joepisconte/Monitoreo-de-Temperatura-de-Pulpa-de-Uva/Fotos de la Calibración de Sensores/3.jpg

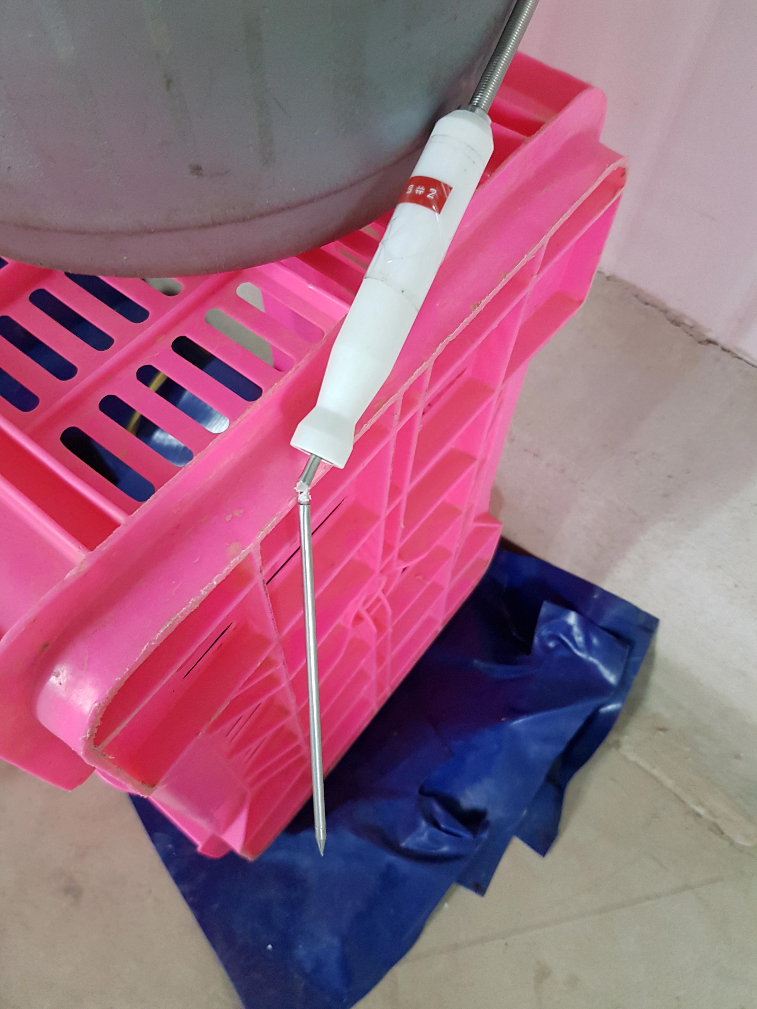
Fotos de la Calibración de Sensores/3.jpg
