joepisconte/Monitoreo-de-Temperatura-de-Pulpa-de-Uva/Librerías para Arduino/PlayingWithFusion_MAX31865/readme.txt

For information on installing libraries, see: http://arduino.cc/en/Guide/Libraries
visit www.playingwithfusion.com for more details, application notes and more!
