joepisconte/Monitoreo-de-Temperatura-de-Pulpa-de-Uva/Programa para Android/Nota.txt

Programa para Android que permite calibrar los tableros de túneles y cámaras.
El PIN de emparejamiento de los módulos Bluetooth es: 2427
