joepisconte/Monitoreo-de-Temperatura-de-Pulpa-de-Uva/Diagramas de Tableros/Tablero de Cámaras.jpg

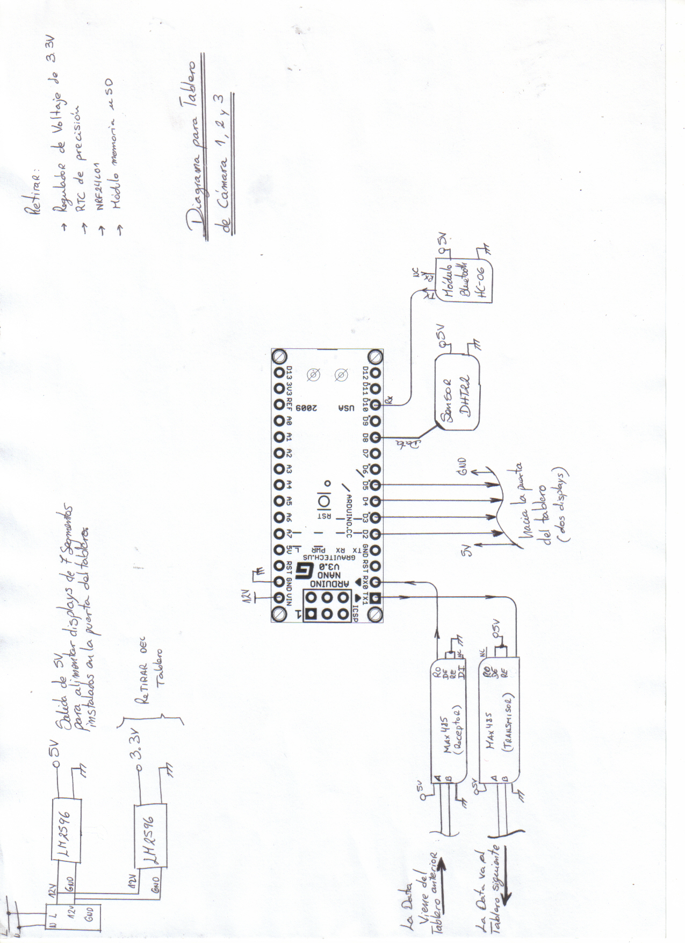
Diagramas de Tableros/Tablero de Cámaras.jpg
