joepisconte/Monitoreo-de-Temperatura-de-Pulpa-de-Uva/Diagramas de Tableros/Tablero de Tuneles.jpg

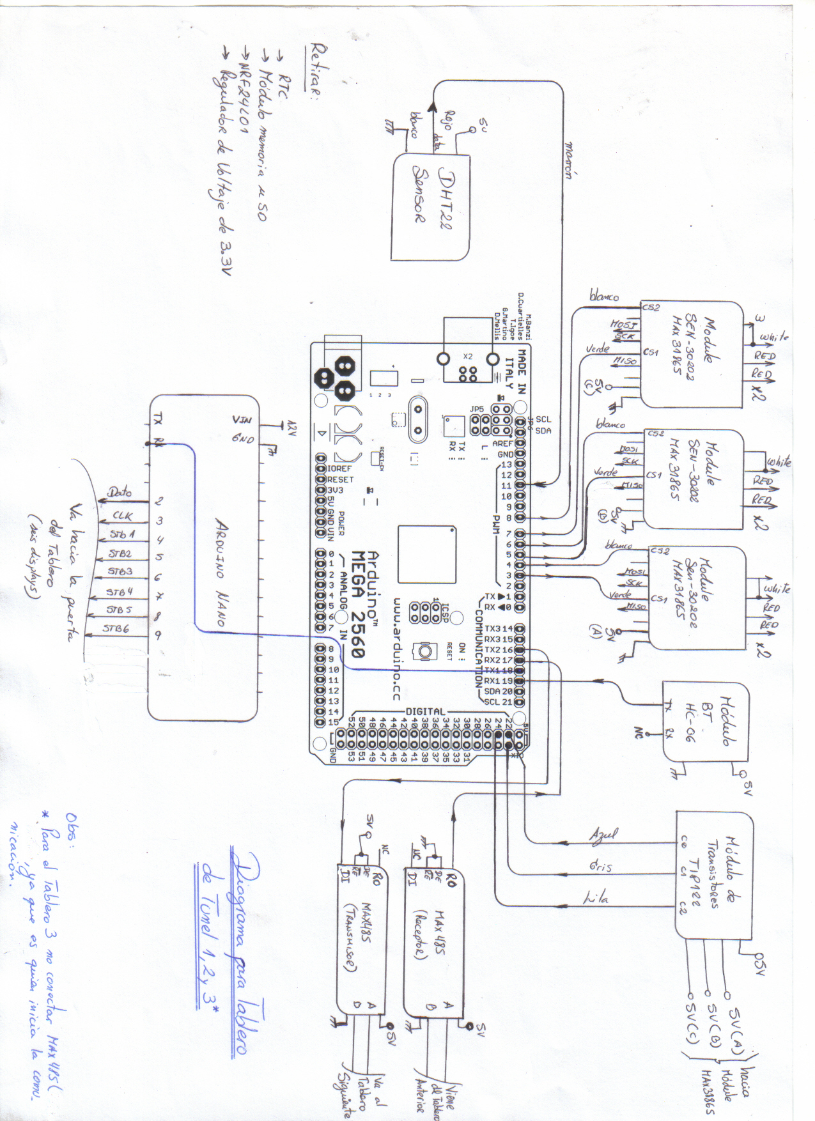
Diagramas de Tableros/Tablero de Tuneles.jpg
