joepisconte/Monitoreo-de-Temperatura-de-Pulpa-de-Uva/Diagramas de Tableros/Tablero Master.jpg

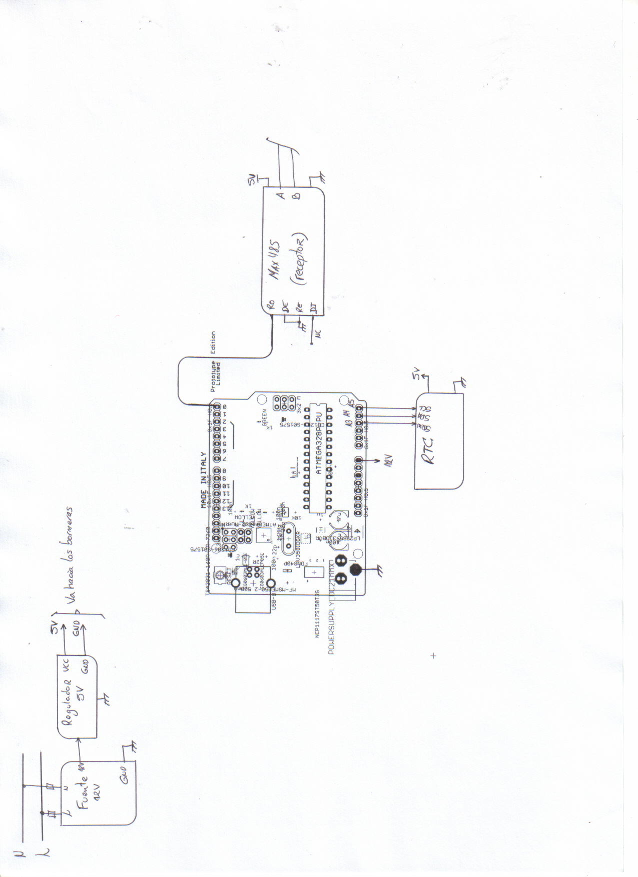
Diagramas de Tableros/Tablero Master.jpg
