joepisconte/Monitoreo-de-Temperatura-de-Pulpa-de-Uva/Fotos de la Calibración de Sensores/Nota.txt

Estas fotos corresponden a la calibración realizada el 21 de Octubre del 2016 en las intalaciones de la empresa Fresch Fruits SRL ubicada en CETICOS PAITA - PIURA - PERÚ.
