joepisconte/Monitoreo-de-Temperatura-de-Pulpa-de-Uva/Fotos de la Calibración de Sensores/1.jpg

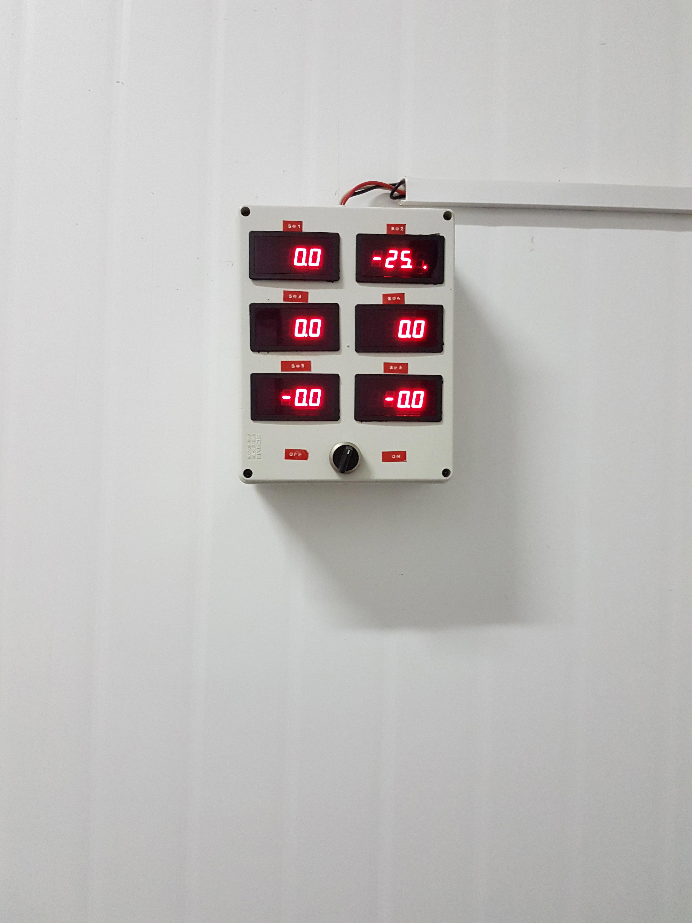
Fotos de la Calibración de Sensores/1.jpg
