joepisconte/Monitoreo-de-Temperatura-de-Pulpa-de-Uva/Fotos de la Calibración de Sensores/7.jpg

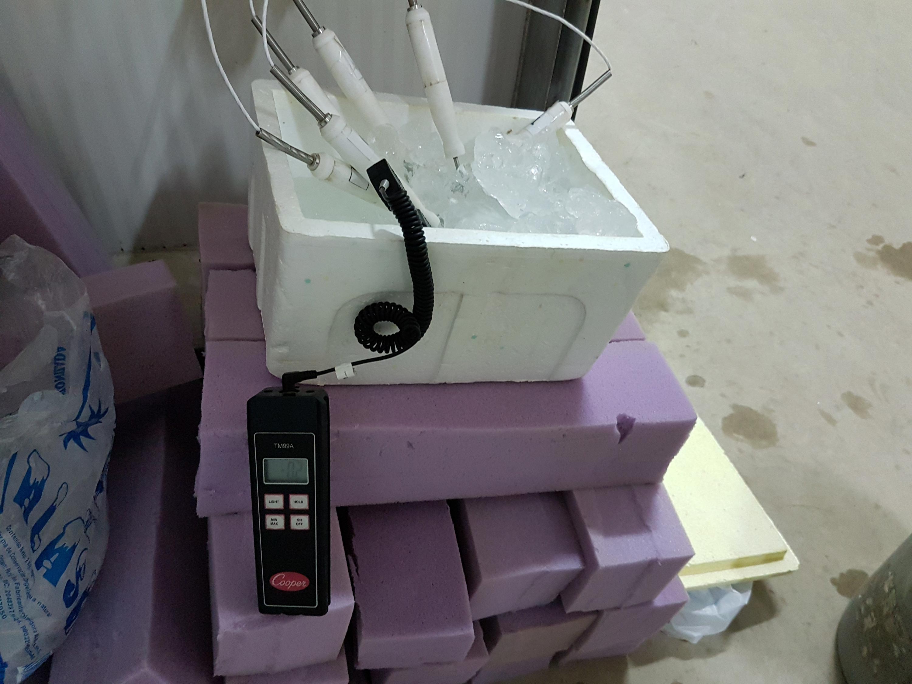
Fotos de la Calibración de Sensores/7.jpg
