joepisconte/Monitoreo-de-Temperatura-de-Pulpa-de-Uva/Librerías para Arduino/PlayingWithFusion_MAX31865/examples/max31865_2ch_spi_example/max31865_2ch_spi_example.ino

/***************************************************************************
* File Name: serial_MAX31865.h
* Processor/Platform: Arduino Uno R3 (tested)
* Development Environment: Arduino 1.0.5
*
* Designed for use with with Playing With Fusion MAX31865 Resistance
* Temperature Device (RTD) breakout board: SEN-30202 (PT100 or PT1000)
*   ---> http://playingwithfusion.com/productview.php?pdid=25
*   ---> http://playingwithfusion.com/productview.php?pdid=26
*
* Copyright © 2014 Playing With Fusion, Inc.
* SOFTWARE LICENSE AGREEMENT: This code is released under the MIT License. 
* 
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
* Playing With Fusion, Inc. invests time and resources developing open-source
* code. Please support Playing With Fusion and continued open-source 
* development by buying products from Playing With Fusion!
*
* **************************************************************************
* ADDITIONAL NOTES:
* This file configures then runs a program on an Arduino Uno to read a 2-ch
* MAX31865 RTD-to-digital converter breakout board and print results to
* a serial port. Communication is via SPI built-in library.
*    - Configure Arduino Uno
*    - Configure and read resistances and statuses from MAX31865 IC 
*      - Write config registers (MAX31865 starts up in a low-power state)
*      - RTD resistance register
*      - High and low status thresholds 
*      - Fault statuses
*    - Write formatted information to serial port
*  Circuit:
*    Arduino Uno   Arduino Mega  -->  SEN-30201
*    CS0: pin  9   CS0: pin  9   -->  CS, CH0
*    CS1: pin 10   CS1: pin 10   -->  CS, CH1
*    MOSI: pin 11  MOSI: pin 51  -->  SDI (must not be changed for hardware SPI)
*    MISO: pin 12  MISO: pin 50  -->  SDO (must not be changed for hardware SPI)
*    SCK:  pin 13  SCK:  pin 52  -->  SCLK (must not be changed for hardware SPI)
*    GND           GND           -->  GND
*    5V            5V            -->  Vin (supply with same voltage as Arduino I/O, 5V)
***************************************************************************/

// the sensor communicates using SPI, so include the hardware SPI library:
#include <SPI.h>
// include Playing With Fusion MAX31865 libraries
#include <PlayingWithFusion_MAX31865.h>              // core library
#include <PlayingWithFusion_MAX31865_STRUCT.h>       // struct library

// CS pin used for the connection with the sensor
// other connections are controlled by the SPI library)
const int CS0_PIN = 9;
const int CS1_PIN = 10;

PWFusion_MAX31865_RTD rtd_ch0(CS0_PIN);
PWFusion_MAX31865_RTD rtd_ch1(CS1_PIN);

void setup() {
  Serial.begin(115200);

  // setup for the the SPI library:
  SPI.begin();                            // begin SPI
  SPI.setClockDivider(SPI_CLOCK_DIV16);   // SPI speed to SPI_CLOCK_DIV16 (1MHz)
  SPI.setDataMode(SPI_MODE3);             // MAX31865 works in MODE1 or MODE3
  
  // initalize the chip select pin
  pinMode(CS0_PIN, OUTPUT);
  pinMode(CS1_PIN, OUTPUT);
  rtd_ch0.MAX31865_config();
  rtd_ch1.MAX31865_config();
  
  // give the sensor time to set up
  delay(100);
}


void loop() 
{
  delay(1500);                                   // 1500ms delay... can be much faster
  

  static struct var_max31865 RTD_CH0;
  static struct var_max31865 RTD_CH1;
  double tmp;
  
  RTD_CH0.RTD_type = 1;                         // un-comment for PT100 RTD
  // RTD_CH0.RTD_type = 2;                        // un-comment for PT1000 RTD
  RTD_CH1.RTD_type = 1;                         // un-comment for PT100 RTD
  // RTD_CH0.RTD_type = 2;                        // un-comment for PT1000 RTD
  
  struct var_max31865 *rtd_ptr;
  rtd_ptr = &RTD_CH0;
  rtd_ch0.MAX31865_full_read(rtd_ptr);          // Update MAX31855 readings 
  
  rtd_ptr = &RTD_CH1;
  rtd_ch1.MAX31865_full_read(rtd_ptr);          // Update MAX31855 readings 
  
  // ******************** Print RTD 0 Information ********************
  Serial.println("RTD Sensor 0:");              // Print RTD0 header
  
  if(0 == RTD_CH0.status)                       // no fault, print info to serial port
  {
    if(1 == RTD_CH0.RTD_type)                   // handle values for PT100
    {
      // calculate RTD resistance
      tmp = (double)RTD_CH0.rtd_res_raw * 400 / 32768;
      Serial.print("Rrtd = ");                  // print RTD resistance heading
      Serial.print(tmp);                        // print RTD resistance
    }
    else if(2 == RTD_CH0.RTD_type)              // handle values for PT1000
    {
      // calculate RTD resistance
      tmp = (double)RTD_CH0.rtd_res_raw * 4000 / 32768;
      Serial.print("Rrtd = ");                  // print RTD resistance heading
      Serial.print(tmp);                        // print RTD resistance
    }
    Serial.println(" ohm");
    // calculate RTD temperature (simple calc, +/- 2 deg C from -100C to 100C)
    // more accurate curve can be used outside that range
    tmp = ((double)RTD_CH0.rtd_res_raw / 32) - 256;
    Serial.print("Trtd = ");                    // print RTD temperature heading
    Serial.print(tmp);                          // print RTD resistance
    Serial.println(" deg C");                   // print RTD temperature heading
  }  // end of no-fault handling
  else 
  {
    Serial.print("RTD Fault, register: ");
    Serial.print(RTD_CH0.status);
    if(0x80 & RTD_CH0.status)
    {
      Serial.println("RTD High Threshold Met");  // RTD high threshold fault
    }
    else if(0x40 & RTD_CH0.status)
    {
      Serial.println("RTD Low Threshold Met");   // RTD low threshold fault
    }
    else if(0x20 & RTD_CH0.status)
    {
      Serial.println("REFin- > 0.85 x Vbias");   // REFin- > 0.85 x Vbias
    }
    else if(0x10 & RTD_CH0.status)
    {
      Serial.println("FORCE- open");             // REFin- < 0.85 x Vbias, FORCE- open
    }
    else if(0x08 & RTD_CH0.status)
    {
      Serial.println("FORCE- open");             // RTDin- < 0.85 x Vbias, FORCE- open
    }
    else if(0x04 & RTD_CH0.status)
    {
      Serial.println("Over/Under voltage fault");  // overvoltage/undervoltage fault
    }
    else
    {
      Serial.println("Unknown fault, check connection"); // print RTD temperature heading
    }
  }  // end of fault handling
  
  
  // ******************** Print RTD 1 Information ********************
  Serial.println("RTD Sensor 1:");              // Print RTD0 header
  
  if(0 == RTD_CH1.status)                       // no fault, print info to serial port
  {
    if(1 == RTD_CH1.RTD_type)                   // handle values for PT100
    {
      // calculate RTD resistance
      tmp = (double)RTD_CH1.rtd_res_raw * 400 / 32768;
      Serial.print("Rrtd = ");                  // print RTD resistance heading
      Serial.print(tmp);                        // print RTD resistance
    }
    else if(2 == RTD_CH1.RTD_type)              // handle values for PT1000
    {
      // calculate RTD resistance
      tmp = (double)RTD_CH1.rtd_res_raw * 4000 / 32768;
      Serial.print("Rrtd = ");                  // print RTD resistance heading
      Serial.print(tmp);                        // print RTD resistance
    }
    Serial.println(" ohm");
    // calculate RTD temperature (simple calc, +/- 2 deg C from -100C to 100C)
    // more accurate curve can be used outside that range
    tmp = ((double)RTD_CH1.rtd_res_raw / 32) - 256;
    Serial.print("Trtd = ");                    // print RTD temperature heading
    Serial.print(tmp);                          // print RTD resistance
    Serial.println(" deg C");                   // print RTD temperature heading
  }  // end of no-fault handling
  else 
  {
    Serial.print("RTD Fault, register: ");
    Serial.print(RTD_CH1.status);
    if(0x80 & RTD_CH1.status)
    {
      Serial.println("RTD High Threshold Met");  // RTD high threshold fault
    }
    else if(0x40 & RTD_CH1.status)
    {
      Serial.println("RTD Low Threshold Met");   // RTD low threshold fault
    }
    else if(0x20 & RTD_CH1.status)
    {
      Serial.println("REFin- > 0.85 x Vbias");   // REFin- > 0.85 x Vbias
    }
    else if(0x10 & RTD_CH1.status)
    {
      Serial.println("FORCE- open");             // REFin- < 0.85 x Vbias, FORCE- open
    }
    else if(0x08 & RTD_CH1.status)
    {
      Serial.println("FORCE- open");             // RTDin- < 0.85 x Vbias, FORCE- open
    }
    else if(0x04 & RTD_CH1.status)
    {
      Serial.println("Over/Under voltage fault");  // overvoltage/undervoltage fault
    }
    else
    {
      Serial.println("Unknown fault, check connection"); // print RTD temperature heading
    }
  }  // end of fault handling
  
}
