joepisconte/Monitoreo-de-Temperatura-de-Pulpa-de-Uva/(commit log)

2016-10-28 Softare Probado el 21 de Octubre del 2010 en FreshCo S.R.L.
    [04-02-16.csv]
2016-10-28 Cambio de letra
2016-11-16 Muestra Temperaturas en 6 módulo de displays
2016-11-16 Detalles de los Tableros de Túneles
